eelcogg/robomow-signal-generator/docs/matched_signal_zoom.png

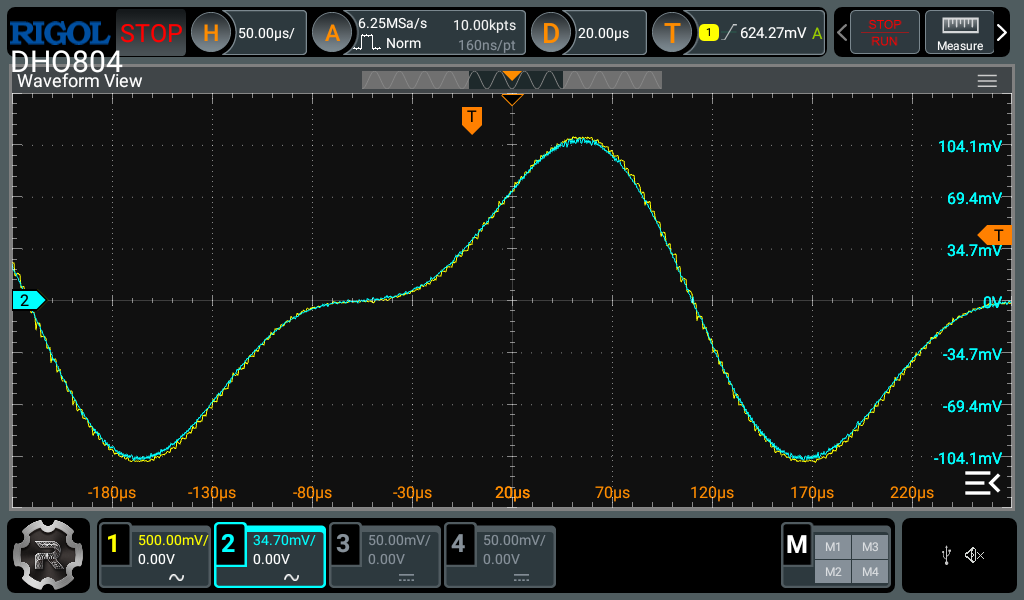
docs/matched_signal_zoom.png
