eelcogg/robomow-signal-generator/docs/sampled_signal.png

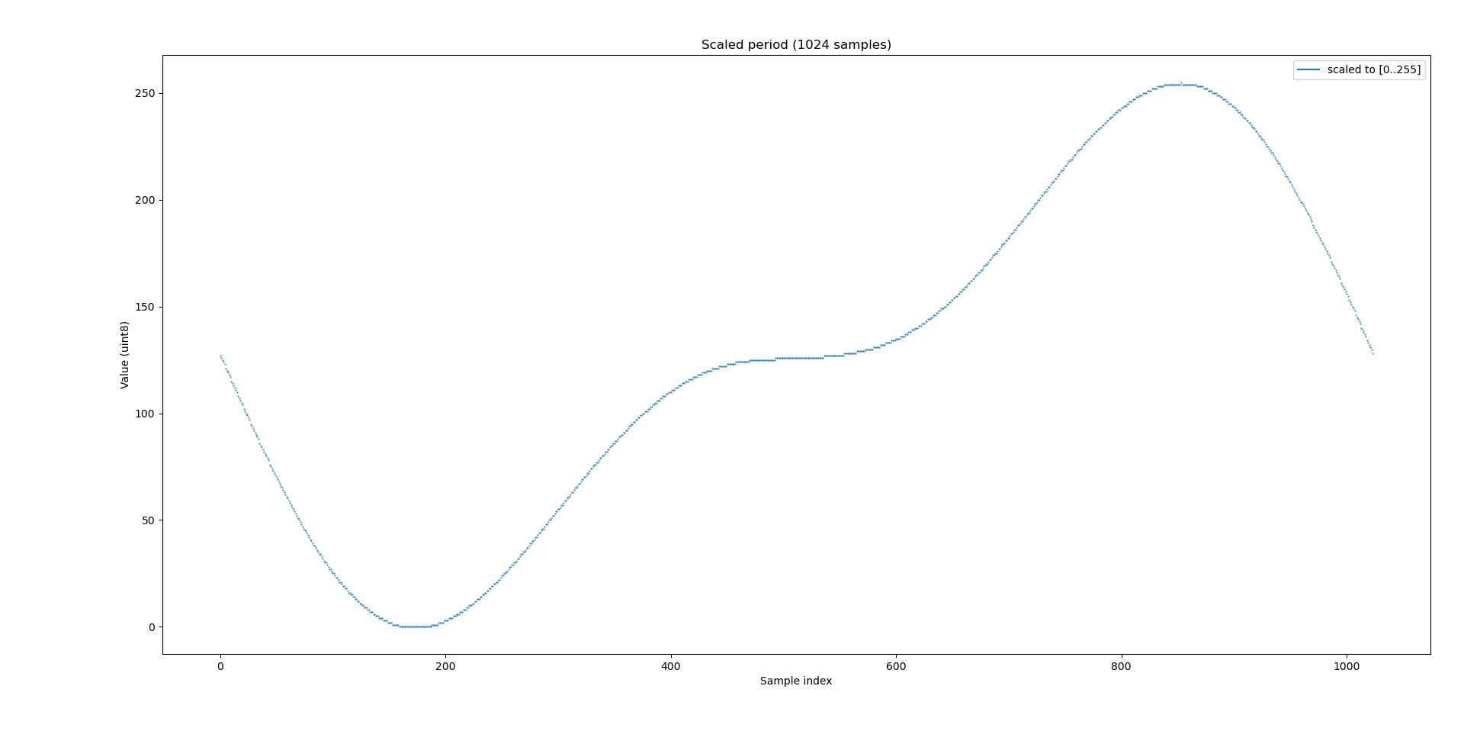
docs/sampled_signal.png
