eelcogg/robomow-signal-generator/src/waveform.h

#ifndef WAVEFORM_H
#define WAVEFORM_H

#include <stdint.h>

// Declare your arbitrary waveform as a constant array in flash.
// Length MUST be a power of two (1024 in your case).
constexpr int WAVEFORM_LEN = 1024;

const uint8_t waveform[1024] = {
    127, 126, 125, 124, 123, 121, 120, 119, 118, 117, 115, 114, 113, 112, 111, 110,
    108, 107, 106, 105, 104, 102, 101, 100,  99,  98,  97,  95,  94,  93,  92,  91,
     90,  89,  88,  86,  85,  84,  83,  82,  81,  80,  79,  78,  76,  75,  74,  73,
     72,  71,  70,  69,  68,  67,  66,  65,  64,  63,  62,  61,  60,  59,  58,  57,
     56,  55,  54,  53,  52,  51,  50,  49,  48,  47,  46,  45,  45,  44,  43,  42,
     41,  40,  39,  38,  38,  37,  36,  35,  34,  34,  33,  32,  31,  30,  30,  29,
     28,  27,  27,  26,  25,  25,  24,  23,  23,  22,  21,  21,  20,  19,  19,  18,
     18,  17,  16,  16,  15,  15,  14,  14,  13,  13,  12,  12,  11,  11,  10,  10,
      9,   9,   9,   8,   8,   7,   7,   7,   6,   6,   5,   5,   5,   4,   4,   4,
      4,   3,   3,   3,   3,   2,   2,   2,   2,   1,   1,   1,   1,   1,   1,   0,
      0,   0,   0,   0,   0,   0,   0,   0,   0,   0,   0,   0,   0,   0,   0,   0,
      0,   0,   0,   0,   0,   0,   0,   0,   0,   0,   0,   0,   1,   1,   1,   1,
      1,   1,   2,   2,   2,   2,   2,   3,   3,   3,   3,   4,   4,   4,   4,   5,
      5,   5,   6,   6,   6,   7,   7,   7,   8,   8,   8,   9,   9,  10,  10,  10,
     11,  11,  12,  12,  13,  13,  13,  14,  14,  15,  15,  16,  16,  17,  17,  18,
     18,  19,  19,  20,  20,  21,  21,  22,  22,  23,  24,  24,  25,  25,  26,  26,
     27,  28,  28,  29,  29,  30,  30,  31,  32,  32,  33,  34,  34,  35,  35,  36,
     37,  37,  38,  39,  39,  40,  40,  41,  42,  42,  43,  44,  44,  45,  46,  46,
     47,  48,  48,  49,  50,  50,  51,  52,  52,  53,  54,  54,  55,  55,  56,  57,
     57,  58,  59,  59,  60,  61,  61,  62,  63,  63,  64,  65,  65,  66,  67,  67,
     68,  69,  69,  70,  70,  71,  72,  72,  73,  74,  74,  75,  76,  76,  77,  77,
     78,  79,  79,  80,  80,  81,  82,  82,  83,  83,  84,  85,  85,  86,  86,  87,
     87,  88,  89,  89,  90,  90,  91,  91,  92,  92,  93,  94,  94,  95,  95,  96,
     96,  97,  97,  98,  98,  99,  99, 100, 100, 101, 101, 101, 102, 102, 103, 103,
    104, 104, 105, 105, 106, 106, 106, 107, 107, 108, 108, 108, 109, 109, 110, 110,
    110, 111, 111, 111, 112, 112, 112, 113, 113, 113, 114, 114, 114, 115, 115, 115,
    116, 116, 116, 116, 117, 117, 117, 117, 118, 118, 118, 118, 119, 119, 119, 119,
    120, 120, 120, 120, 120, 121, 121, 121, 121, 121, 121, 122, 122, 122, 122, 122,
    122, 122, 123, 123, 123, 123, 123, 123, 123, 123, 124, 124, 124, 124, 124, 124,
    124, 124, 124, 124, 124, 124, 125, 125, 125, 125, 125, 125, 125, 125, 125, 125,
    125, 125, 125, 125, 125, 125, 125, 125, 125, 125, 125, 125, 125, 126, 126, 126,
    126, 126, 126, 126, 126, 126, 126, 126, 126, 126, 126, 126, 126, 126, 126, 126,
    126, 126, 126, 126, 126, 126, 126, 126, 126, 126, 126, 126, 126, 126, 126, 126,
    126, 126, 126, 126, 126, 126, 126, 126, 127, 127, 127, 127, 127, 127, 127, 127,
    127, 127, 127, 127, 127, 127, 127, 127, 127, 127, 128, 128, 128, 128, 128, 128,
    128, 128, 128, 128, 128, 129, 129, 129, 129, 129, 129, 129, 129, 130, 130, 130,
    130, 130, 130, 130, 131, 131, 131, 131, 131, 131, 132, 132, 132, 132, 132, 133,
    133, 133, 133, 133, 134, 134, 134, 134, 135, 135, 135, 135, 136, 136, 136, 136,
    137, 137, 137, 138, 138, 138, 139, 139, 139, 140, 140, 140, 141, 141, 141, 142,
    142, 142, 143, 143, 144, 144, 144, 145, 145, 146, 146, 146, 147, 147, 148, 148,
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
};

#endif // WAVEFORM_H
